ucandevices/CFDC_embedded/firmware/README.md

# Embedded software for CAN FD USB CONVERTER

## How to build
To compile the software use [Visual Studio Code STM32 extension](https://marketplace.visualstudio.com/items?itemName=bmd.stm32-for-vscode).

MCU configuration was generated using STM32CubeIDE
