ucandevices/CFDC_embedded/pcb/README.md

# PCB board

To open schematic and PCB use KiCad 5.1.4 or higher.
