ucandevices/CFDC_embedded/tools/README.md

# Tools 

* There are two python CAN examples one for reception and transmission of CAN frames.

* CFUC_Upload.sh is used to upload new firmware via STM32 USB bootloader using STM32CubeProgramer Software

* There is python application for send and view frames on CAN see uCAN_CAN_Viewer
