ucandevices/CFDC_embedded/doc/USBMCS1B5W.pdf

A

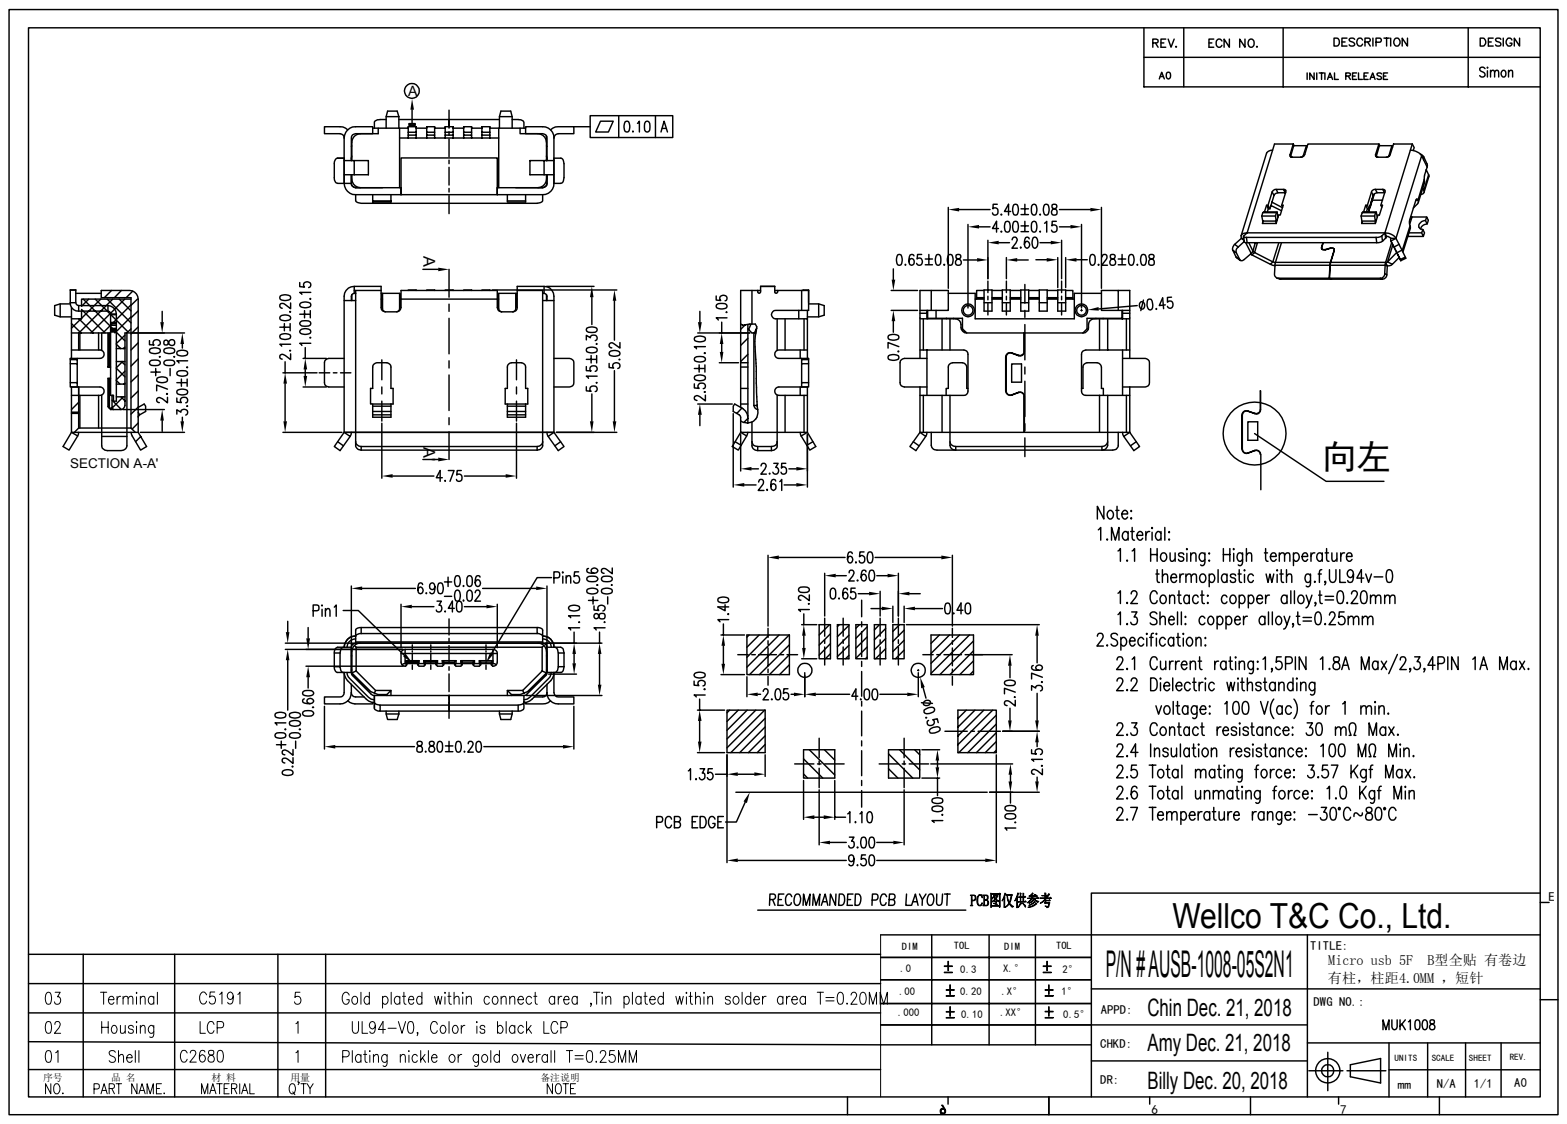
[picture p1: page 1]
SECTION A-A'; UNITS; CHKD:; APPD:; SCALE; SHEET; REV.; 备注说明

Wellco T&C Co., Ltd.
P/N # AUSB-1008-05S2N1
Chin Dec. 21, 2018
Amy Dec. 21, 2018
Billy Dec. 20, 2018

DIM | TOL | DIM | TOL

TITLE:
Micro usb 5F B型全贴 有卷边
DWG NO.:
