ucandevices/CFDC_embedded/pcb/main/main.pdf

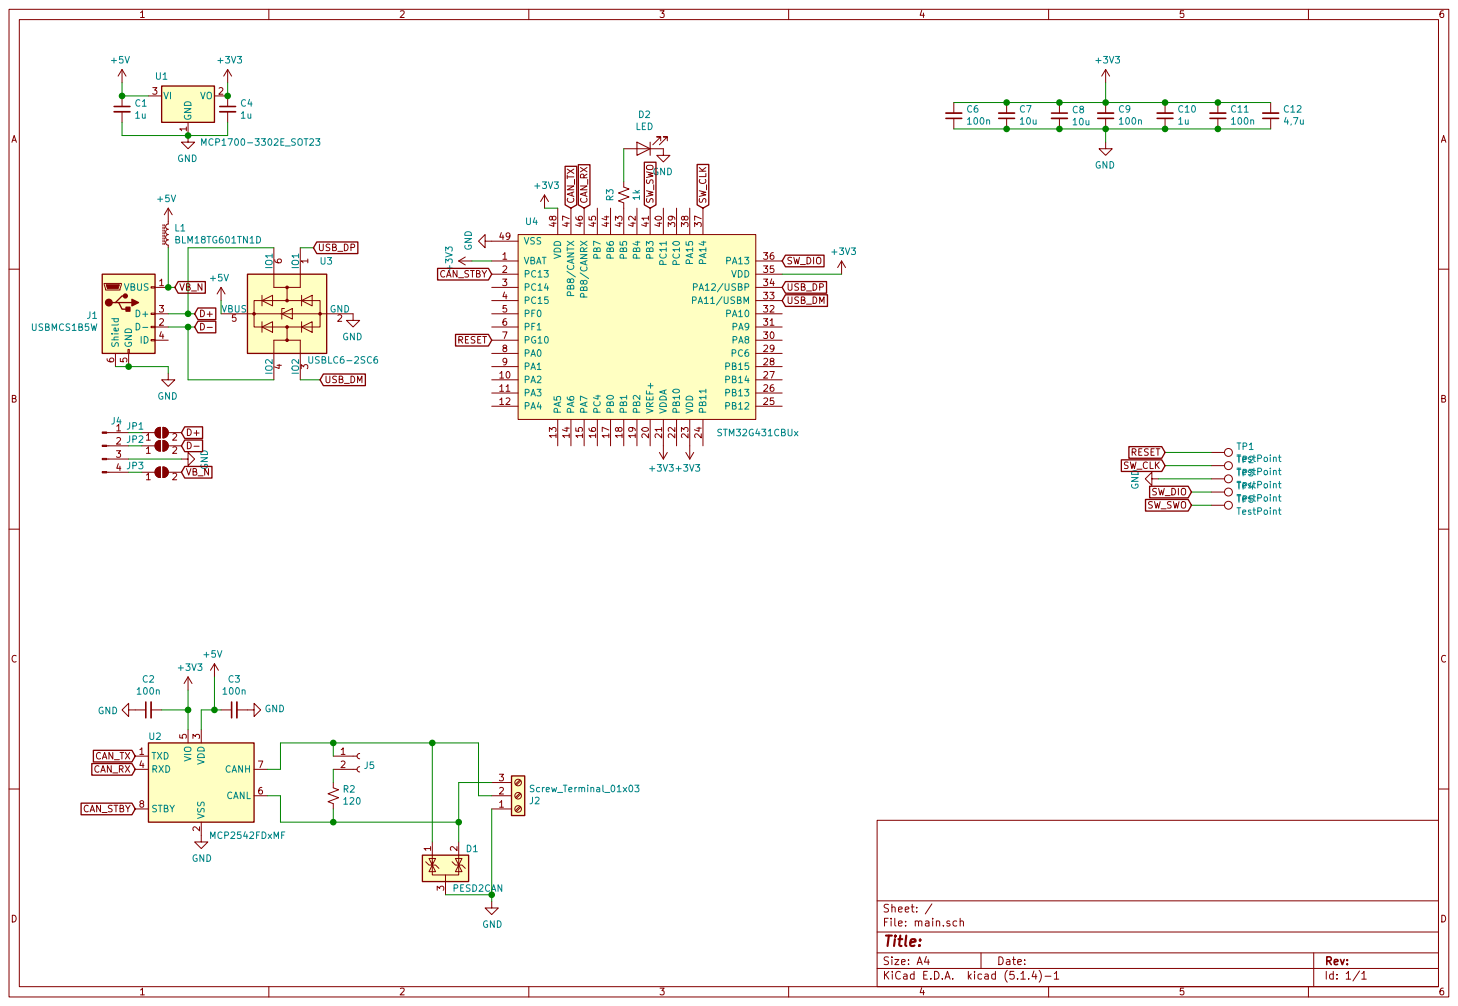
[picture p2: page 1]

Id: 1/1 Title: File: main.sch Sheet: /
