ucandevices/CFDC_embedded/pcb/main/main.kicad_pcb

## KiCad design pcb/main/main.kicad_pcb (2022-10-15)

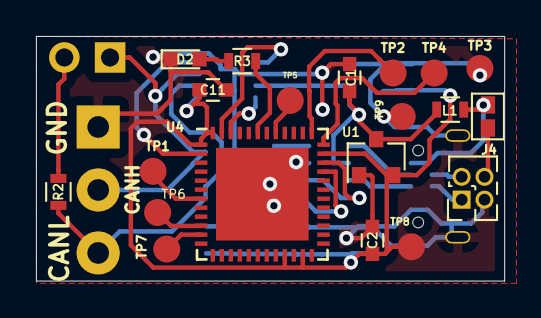
[picture p3: board main.kicad_pcb from above]

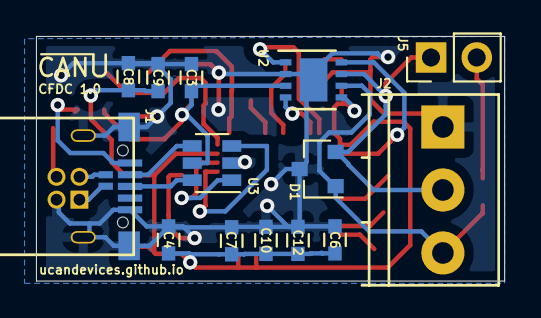
[picture p4: board main.kicad_pcb from below]

Board: 2 copper layers, 26.0 x 13.6 mm, 36 parts (16 on the bottom side), 25 nets.

Parts:
C1, C4, C10: 1u; C_0603
C2, C3, C6, C9, C11: 100n; C_0603
C7, C8: 10u; C_0603
C12: 4,7u; C_0603
D1: PESD2CAN; SOT-23
D2: LED; LED_0603
J1: USBMCS1B5W
J2: Screw_Terminal_01x03/3,5; TerminalBlock_Phoenix_PT-3.5mm_3pol
J4: Conn_01x04_Male; Pin_Header_Straight_2x02_Pitch1.27mm
J5: Conn_01x02_Female; Pin_Header_Straight_1x02_Pitch2.54mm
JP1, JP2: SolderJumper_2_Open; mini_GS2
JP3: SolderJumper_2_Open; GS2
L1: BLM18TG601TN1D; R_0603
R2: 120; R_0603
R3: 1k; R_0603
TP1, TP2, TP3, TP4, TP5, TP6, TP7, TP8, TP9: TestPoint; Measurement_Point_Round-SMD-Pad_Small
U1: MCP1700-3302E_SOT23; SOT-23
U2: MCP2542FDxMF; DFN-8-1EP_3x3mm_Pitch0.65mm
U3: USBLC6-2SC6; SOT-23-6
U4: STM32G431CBUx; QFN-48-1EP_7x7mm_Pitch0.5mm

Connections:
+3V3: C2.2, C4.1, C6.2, C7.2, C8.1, C9.2, C10.2, C11.2, C12.2, TP8.1, U1.2, U2.5, U4.1, U4.21, U4.23, U4.35, U4.48
+5V: C1.1, C3.1, L1.2, U1.3, U2.3, U3.5
/CANH: D1.2, J2.2, J5.1, U2.7
/CANL: D1.1, J2.3, R2.1, U2.6
CAN_RX: U2.4, U4.46
CAN_STBY: U2.8, U4.2
CAN_TX: U2.1, U4.47
D+: J1.3, U3.6
D-: J1.2, U3.4
GND: C1.2, C2.1, C3.2, C4.2, C6.1, C7.1, C8.2, C9.1, C10.1, C11.1, C12.1, D1.3, D2.1, J1.5, J1.6, J2.1, J4.3, TP3.1, TP9.1, U1.1, U2.2, U2.9, U3.2, U4.49
unnamed: D2.2, R3.2
unnamed: J4.1, JP1.1
unnamed: J4.2, JP2.1
unnamed: J4.4, JP3.1
unnamed: J5.2, R2.2
unnamed: R3.1, U4.43
unnamed: TP6.1, U4.10
unnamed: TP7.1, U4.11
RESET: TP1.1, U4.7
SW_CLK: TP2.1, U4.37
SW_DIO: TP4.1, U4.36
SW_SWO: TP5.1, U4.41
USB_DM: U3.3, U4.33
USB_DP: U3.1, U4.34
VB_N: J1.1, JP3.2, L1.1
