ucandevices/CFDC_embedded/(threads)

Thread 8 (2023-01-22):

Missing cfuc module in python-can

KhazAkar, 2023-01-22:
Hi,
It's advertised that this project have python-can support, but I cannot find cfuc module neither in official python-can repo, nor in linked fork. This renders python examples as unusable.
Is this device supported using slcan/serial as basis for a driver? If so, maybe that would be a great idea to modify firmware to be compatible with pytho-can slcan?

Lukasz-Juranek, 2023-01-25:
Support is here https://github.com/Lukasz-Juranek/python-can/tree/can-interface-cfuc/can/interfaces/cfuc , yes i need to work on merging driver for python-can.

slcan/serial -- device is currently discovered as USB Serial, slcan does not support CAN-FD

KhazAkar, 2023-01-25:
Okay, found it, thanks!
If slcan does not support CAN FD, maybe it would be a good approach to add support for CAN FD in this module? Plus, in your fork I've created PR to update sources, might be useful :)

KhazAkar, 2023-02-20:
Hi, quick update - it seems that slcan have support for CAN FD, at least in beta stage. If some help is needed, we can do something :)
BTW, received your device today, looks cute! :)

Lukasz-Juranek, 2023-02-20:
Help would be great @KhazAkar write me mail on [ucandevices@mail.com](mailto:ucandevices@mail.com)

Thread 9 (2023-04-23):

Firmware upgrade procedure

KhazAkar, 2023-04-23:
Hello!
Since we got gsusb firmware version for cfdc/cfuc devices, is there any firmware upgrade procedure available for user to do? It would be great to have it, for existing customers ;)

Cheers,
Damian

KhazAkar, 2023-05-07:
Thanks!
i just have one issue tho - where I can find java application? I've tried python tool from this repo, but it complains about bus.go_to_bootloader() ...

Lukasz-Juranek, 2023-05-13:
Hi To switch device to DFU just send over Serialport

https://github.com/ucandevices/CFDC_embedded/blob/830aa4006f803b5ef1e0f853225115626095f5bf/firmware/Inc/ucan_fd_protocol_stm32g431.h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

which should be  0x04

niedz., 7 maj 2023 o 22:55 Damian Zaręba ***@***.***>
napisał(a):

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

KhazAkar, 2023-05-13:
I'm trying, but my minicom on ttyACM0 still says 'Offline', as well as sending commands using echo or cat does not help. I'm setting 115200 baudrate using stty -F. Do I miss something?

KhazAkar, 2023-05-13:
Exact commands I'm using:
stty -F /dev/ttyACM0 115200
echo -e "\x04" > /dev/ttyACM0
minicom -b 115200 -D /dev/ttyACM0 (shows offline)
No reaction on any of this.

KhazAkar, 2023-06-02:
Tested on different machine, where I didn't had 'offline' - sending commands using gtkterm, minicom and screen don't work. Using pyserial module as well. No reaction from HW. Any idea? FW is at version before port to gsusb.

Lukasz-Juranek, 2023-06-03:
this is no longer supported write me an email on  ***@***.***   with
your address. I will resend you new devices, it would be great if you could
send me back this broken one. I will look into why it is not working as
expected.

pt., 2 cze 2023 o 22:54 Damian Zaręba ***@***.***> napisał(a):

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
