ucandevices/CFDC_embedded/firmware/Src/main.c

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

/* Includes ------------------------------------------------------------------*/
#include "main.h"
#include "fdcan.h"
#include "usb_device.h"
#include "gpio.h"

/* USER CODE BEGIN Includes */
#include "ucan_fd_protocol_stm32g431.h"
#include "ring.h"
#include "usbd_cdc.h"
#include "dwt_delay.h"
#include "usbd_cdc_if.h"
#include "bootloader.h"
/* USER CODE END Includes */

/* USER CODE BEGIN PTD */
extern USBD_HandleTypeDef hUsbDeviceFS;

/* USER CODE END PTD */


/* USER CODE BEGIN PV */
Ring_buffer_type usb_rx;
Ring_buffer_type usb_tx;
UCAN_RxFrameDef can_rx_frame = { UCAN_FD_RX,	0, {} };

/* USER CODE END PV */

void SystemClock_Config(void);
/**
  * @brief  The application entry point.
  * @retval int
  */
int main(void)
{
  /* MCU Configuration--------------------------------------------------------*/

  /* Reset of all peripherals, Initializes the Flash interface and the Systick. */
  HAL_Init();

  /* USER CODE BEGIN Init */
	DWT_Init();

  /* USER CODE END Init */

  /* Configure the system clock */
  SystemClock_Config();

  /* Initialize all configured peripherals */
  MX_GPIO_Init();
  MX_USB_Device_Init();
  MX_FDCAN1_Init();
  /* USER CODE BEGIN 2 */
	HAL_FDCAN_Start(&hfdcan1);
	ring_buffer_init(&usb_rx);
	ring_buffer_init(&usb_tx);
  HAL_GPIO_WritePin(CAN_STBY_Pin, CAN_STBY_GPIO_Port, GPIO_PIN_RESET);
  /* USER CODE END 2 */

  /* Infinite loop */
  /* USER CODE BEGIN WHILE */

	while (1)
  {
		static Ring_item_type *data_ptr;

		data_ptr = ring_buffer_get(&usb_rx);

		if (data_ptr->data != NULL) 
    {
			UCAN_execute_USB_to_CAN_frame(data_ptr->data);
		}

    if (CDC_Is_Busy() != USBD_BUSY)
    {
      if (can_rx_frame.can_frame_count > 0)
      {
        data_ptr->data = (uint8_t*)&can_rx_frame;
        data_ptr->len = sizeof(UCAN_RxFrameDef);
      } 
      else  /* handle rest of frames is no CAN transactions */
      {
        data_ptr = ring_buffer_get(&usb_tx);
      }

      if (data_ptr->len != 0) 
      {
        while (CDC_Transmit_FS(data_ptr->data, data_ptr->len) == USBD_BUSY);

        if (data_ptr->len == sizeof(UCAN_RxFrameDef))
        {
          can_rx_frame.can_frame_count = 0;
        }
      }
    }

		if (HAL_FDCAN_GetRxFifoFillLevel(&hfdcan1, FDCAN_RX_FIFO0)) // Receiving frames from canbus
    {
			if (can_rx_frame.can_frame_count < UCAN_RX_FRAME_DEF_CAN_COUNT_MAX)
			{
				if (HAL_FDCAN_GetRxMessage(&hfdcan1, FDCAN_RX_FIFO0,
						&(can_rx_frame.can_frame[can_rx_frame.can_frame_count].can_rx_header),
						can_rx_frame.can_frame[can_rx_frame.can_frame_count].can_data) == HAL_OK)
				{
          HAL_GPIO_TogglePin(LED_GPIO_Port, LED_Pin);
          can_rx_frame.can_frame_count ++;
				}
			}
		}

    /* USER CODE END WHILE */

    /* USER CODE BEGIN 3 */
	}
  /* USER CODE END 3 */
}

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
