ucandevices/CFDC_embedded/firmware/CDC_libUSB_basic.ioc

Mcu.UserName=STM32G431CBUx
PA11.Signal=USB_DM
PA12.Signal=USB_DP
PB5.GPIO_Label=LED
PB5.Signal=GPIO_Output
PB8-BOOT0.Signal=FDCAN1_RX
PB9.Signal=FDCAN1_TX
PC13.GPIO_Label=CAN_STBY
PC13.Signal=GPIO_Output
PF0-OSC_IN.Signal=RCC_OSC_IN
