ucandevices/CFDC_embedded/firmware/Inc/main.h

#define CAN_STBY_Pin GPIO_PIN_13
#define CAN_STBY_GPIO_Port GPIOC
#define LED_Pin GPIO_PIN_5
#define LED_GPIO_Port GPIOB
