ucandevices/CFDC_embedded/gsusb_firmware/budgetcan_fw/Portable/board_ucan_gsusb/Inc/board.h

/*

The MIT License (MIT)

Copyright (c) 2022 Ryan Edwards

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
*/

/* Define to prevent recursive inclusion -------------------------------------*/
#ifndef __BOARD_H__
#define __BOARD_H__

#ifdef __cplusplus
extern "C" {
#endif

/* Includes ------------------------------------------------------------------*/
#include "usbd_def.h"

#define BOARD_SYSMEM_RESET_VECTOR	 0x1FFF0000

#define USBD_VID					 0x1D50
#define USBD_LANGID_STRING			 1033
#define USBD_MANUFACTURER_STRING	 (uint8_t*) "ucandevices"
#define USBD_PID_FS					 0x606F
#define USBD_PRODUCT_STRING_FS		 (uint8_t*) "cfuc"
#define USBD_CONFIGURATION_STRING	 (uint8_t*) "gs_usb"
#define USBD_INTERFACE_STRING		 (uint8_t*) "gs_usb interface"
#define DFU_INTERFACE_STRING		 (uint8_t*) "cfuc DFU interface"

#define FDCAN_SJW_INIT				 1
#define FDCAN_BRP_INIT				 90
#define FDCAN_TS1_INIT				 13
#define FDCAN_TS2_INIT				 2

#define FDCAN_DATA_SJW_INIT			 4
#define FDCAN_DATA_BRP_INIT			 2
#define FDCAN_DATA_TS1_INIT			 15
#define FDCAN_DATA_TS2_INIT			 4

#define FDCAN_CLOCK_DIV_INIT		 FDCAN_CLOCK_DIV1
#define FDCAN_FRAME_FMT_INIT		 FDCAN_FRAME_FD_BRS
#define FDCAN_MODE_INIT				 FDCAN_MODE_NORMAL
#define FDCAN_AUTO_RETX_INIT		 DISABLE
#define FDCAN_AUTO_TX_PAUSE_INIT	 DISABLE
#define FDCAN_PROT_EXCPTN_INIT		 ENABLE
#define FDCAN_STD_FLTR_NUM_INIT		 0
#define FDCAN_EXT_FLTR_NUM_INIT		 0

#define FDCAN_TX_FIFO_OPERATION_INIT FDCAN_TX_FIFO_OPERATION
#define FDCAN_MSG_RAM_OFST_INIT		 0
#define FDCAN_RX_FIFO0_ELEM_NUM_INIT 64
#define FDCAN_RX_FIFO0_ELEM_SZ_INIT	 FDCAN_DATA_BYTES_64
#define FDCAN_RX_FIFO1_ELEM_NUM_INIT 64
#define FDCAN_RX_FIFO1_ELEM_SZ_INIT	 FDCAN_DATA_BYTES_64
#define FDCAN_RX_BUFF_NUM_INIT		 64
#define FDCAN_RX_BUFF_SZ_INIT		 FDCAN_DATA_BYTES_64
#define FDCAN_TX_EVNT_NUM_INIT		 32
#define FDCAN_TX_BUFF_NUM_INIT		 32
#define FDCAN_TX_FIFO_ELEM_NUM_INIT	 32
#define FDCAN_TX_FIFO_ELEM_SZ_INIT	 FDCAN_DATA_BYTES_64

#define CAN_NUM_CHANNELS			 1
#define CAN_CLOCK_SPEED				 144000000
#define CANFD_FEATURE_ENABLED

#define BOARD_TIM2_PRESCALER   64-1

#define QUEUE_SIZE_HOST_TO_DEV 64
#define QUEUE_SIZE_DEV_TO_HOST 32

// #define USER_BTN_K1_Pin		   GPIO_PIN_3
// #define USER_BTN_K1_GPIO_Port  GPIOE
// #define LED1_Pin			   GPIO_PIN_1
// #define LED1_GPIO_Port		   GPIOA
// #define USER_BTN_K2_Pin		   GPIO_PIN_5
// #define USER_BTN_K2_GPIO_Port  GPIOC

void SystemClock_Config(void);
void MX_GPIO_Init(void);

#ifdef __cplusplus
}
#endif
#endif /*__ BOARD_H__ */
