ucandevices/CFDC_embedded/firmware/Inc/dwt_delay.h

/*
 * Simple microseconds delay routine, utilizing ARM's DWT
 * (Data Watchpoint and Trace Unit) and HAL library.
 * Intended to use with gcc compiler, but I hope it can be used
 * with any other C compiler across the Universe (provided that
 * ARM and CMSIS already invented) :)
 * Max K
 *
 *
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
 * us_delay is distributed in the hope that it will be useful,
 * but WITHOUT ANY WARRANTY; without even the implied warranty
 * of MERCHANTABILITY or FITNESS FOR A PARTICULAR PURPOSE. See
 * the GNU General Public License for more details.
 * http://www.gnu.org/licenses/.
 */

#include <stdint.h>

#ifndef INC_DWT_DELAY_H_
#define INC_DWT_DELAY_H_

#define DWT_DELAY_NEWBIE 0

void DWT_Init(void);
void DWT_Delay(uint32_t us);


void DWT_us_Timer_Start(uint32_t us);
uint8_t DWT_us_Timer_Done(void);

#endif /* INC_DWT_DELAY_DWT_DELAY_H_ */
