ucandevices/CFDC_embedded/(commit log)

2022-10-15 Release 1.0
    [main.kicad_pcb, main.sch]
2022-11-26 Add config eddition button
