ucandevices/CFDC_embedded/(notices)

Notices in the files:
firmware/Inc/main.h:
© Copyright (c) 2020 STMicroelectronics.
All rights reserved.
This software component is licensed by ST under Ultimate Liberty license
(C) COPYRIGHT STMicroelectronics *****END OF FILE
firmware/Src/dwt_delay.c:
under the terms of the GNU General Public License as published by
the Free Software Foundation, either version 3 of the License,
or (at your option) any later version.
